TeYenWu/iWood/README.md

# iWood: Makeable Vibration Sensor for Interactive Plywood

## About
iWood is interactive plywood that can sense vibration based on triboelectric effect. As a material, iWood survives common woodworking operations, such as sawing, screwing, and nailing and can be used to create furniture and artifacts. Things created using iWood inherit its sensing capability and can detect a variety of user input and activities based on their unique vibration patterns. 

[[Project Video]](https://www.youtube.com/watch?v=MELff8HCPHg) [[PDF]](./assets/iWood.pdf) [[DOI]](/)

iWood

## Hardware
[Hadware page](./Hardware/README.md) descrbies how iWood can be fabricated and how smart things can be created using iWood.

## Firmware
No firmware now

## Software
[Software page](./Software/README.md) shows how to run iWood software programs, including the steps of data collection, training and demo.
