TeYenWu/iWood/Software/server/cm/confusion_matrix_cross-user.jpg

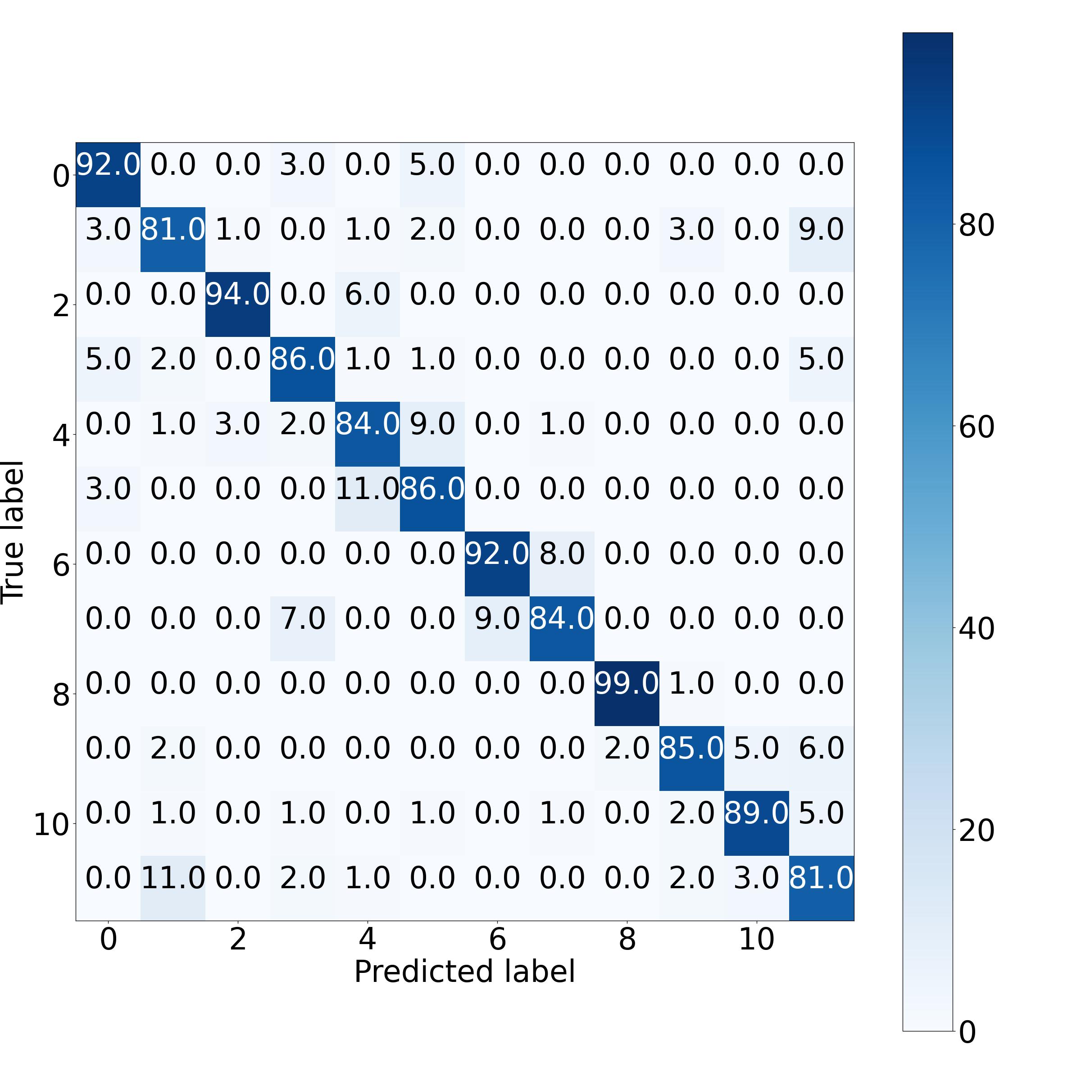
Software/server/cm/confusion_matrix_cross-user.jpg
