TeYenWu/iWood/Software/server/cm/confusion_matrix_cross_thing.jpg

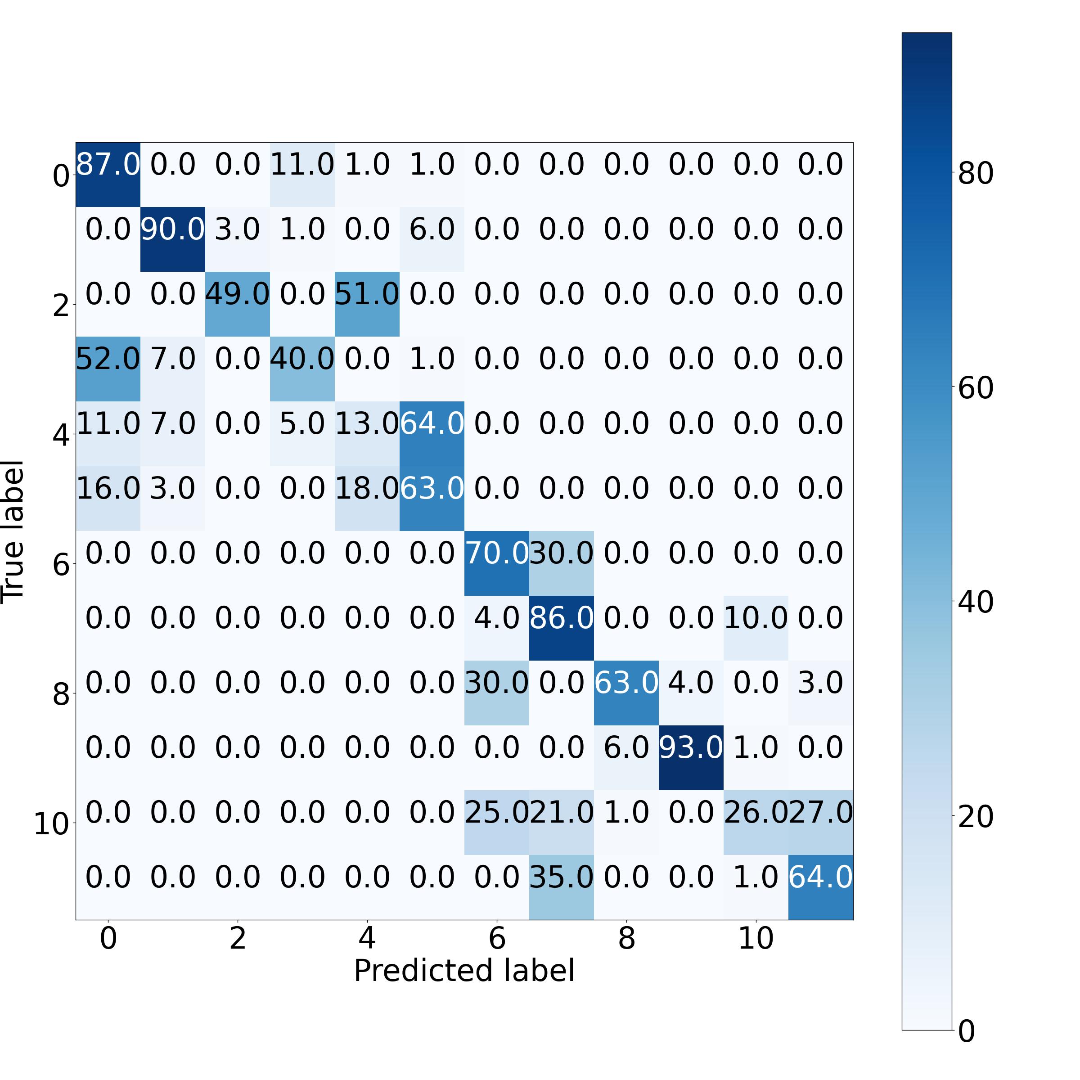
Software/server/cm/confusion_matrix_cross_thing.jpg
