TeYenWu/iWood/Software/server/cm/confusion_matrix_cuttingboard-cross-user.jpg

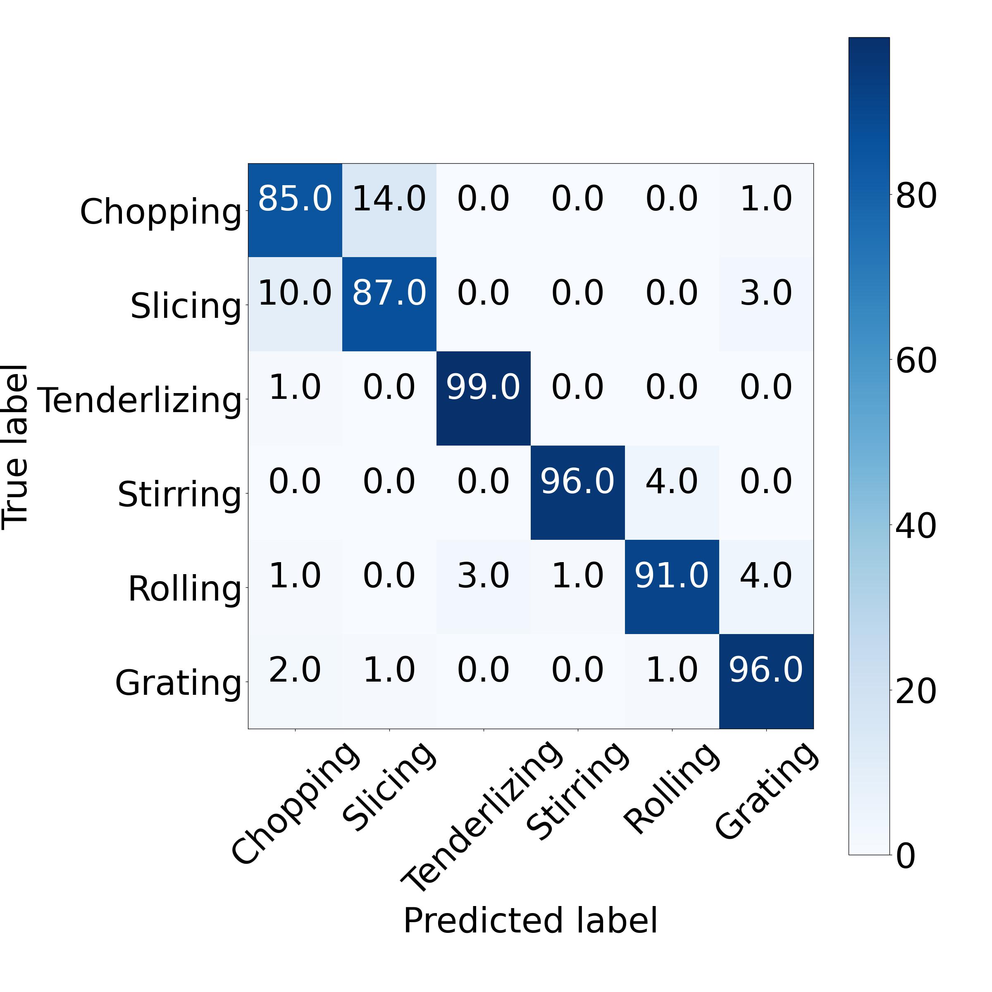
Software/server/cm/confusion_matrix_cuttingboard-cross-user.jpg
