TeYenWu/iWood/Software/server/cm/confusion_matrix_cuttingboard_crossuser.jpg

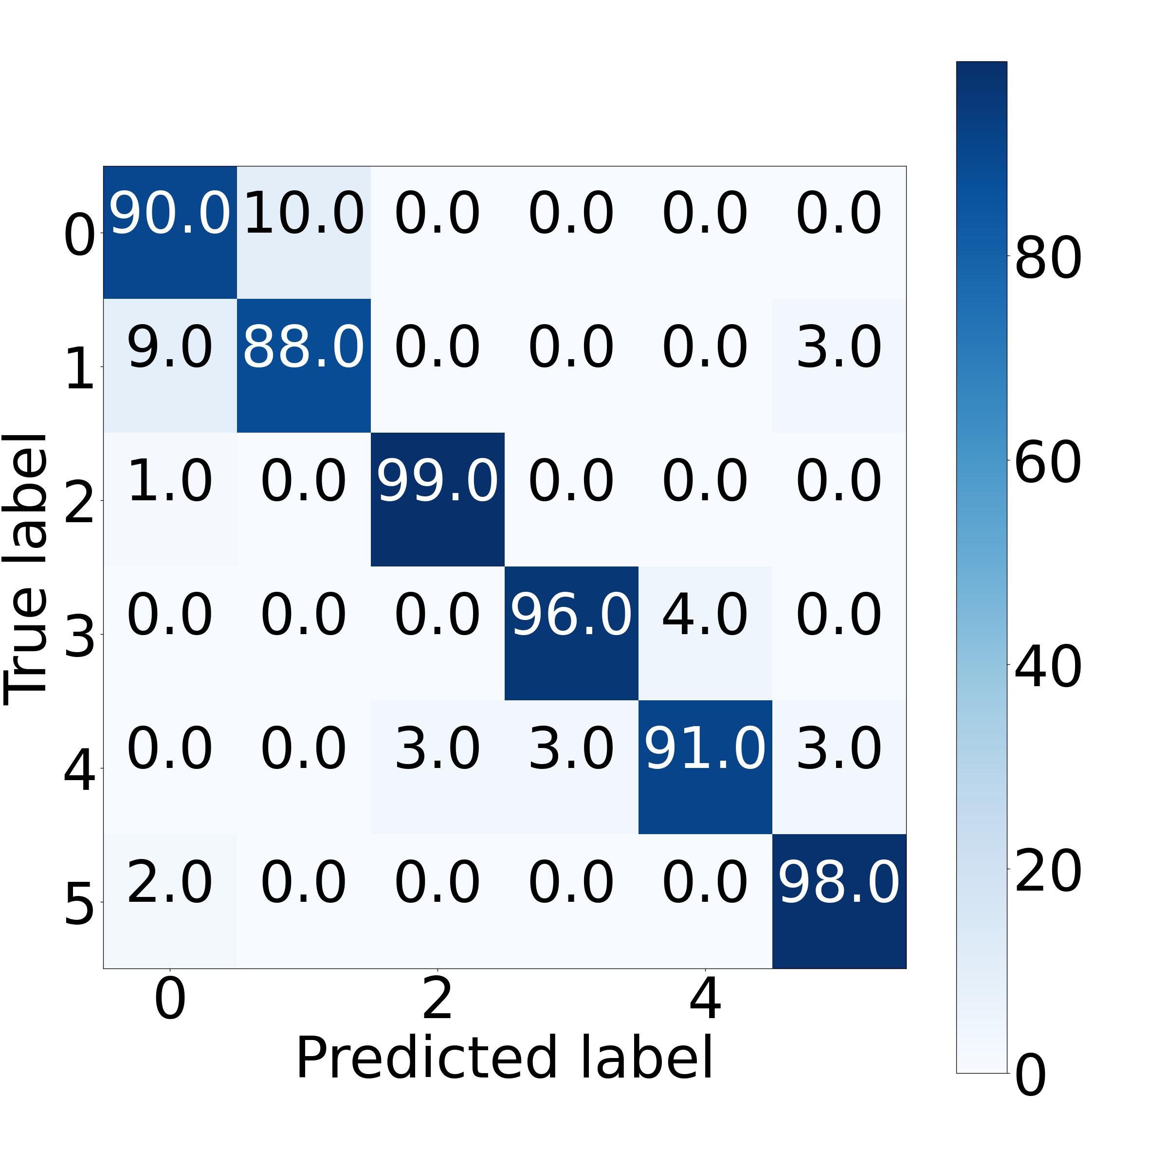
Software/server/cm/confusion_matrix_cuttingboard_crossuser.jpg
