TeYenWu/iWood/Software/server/cm/confusion_matrix_cuttingboard_withinuser.jpg

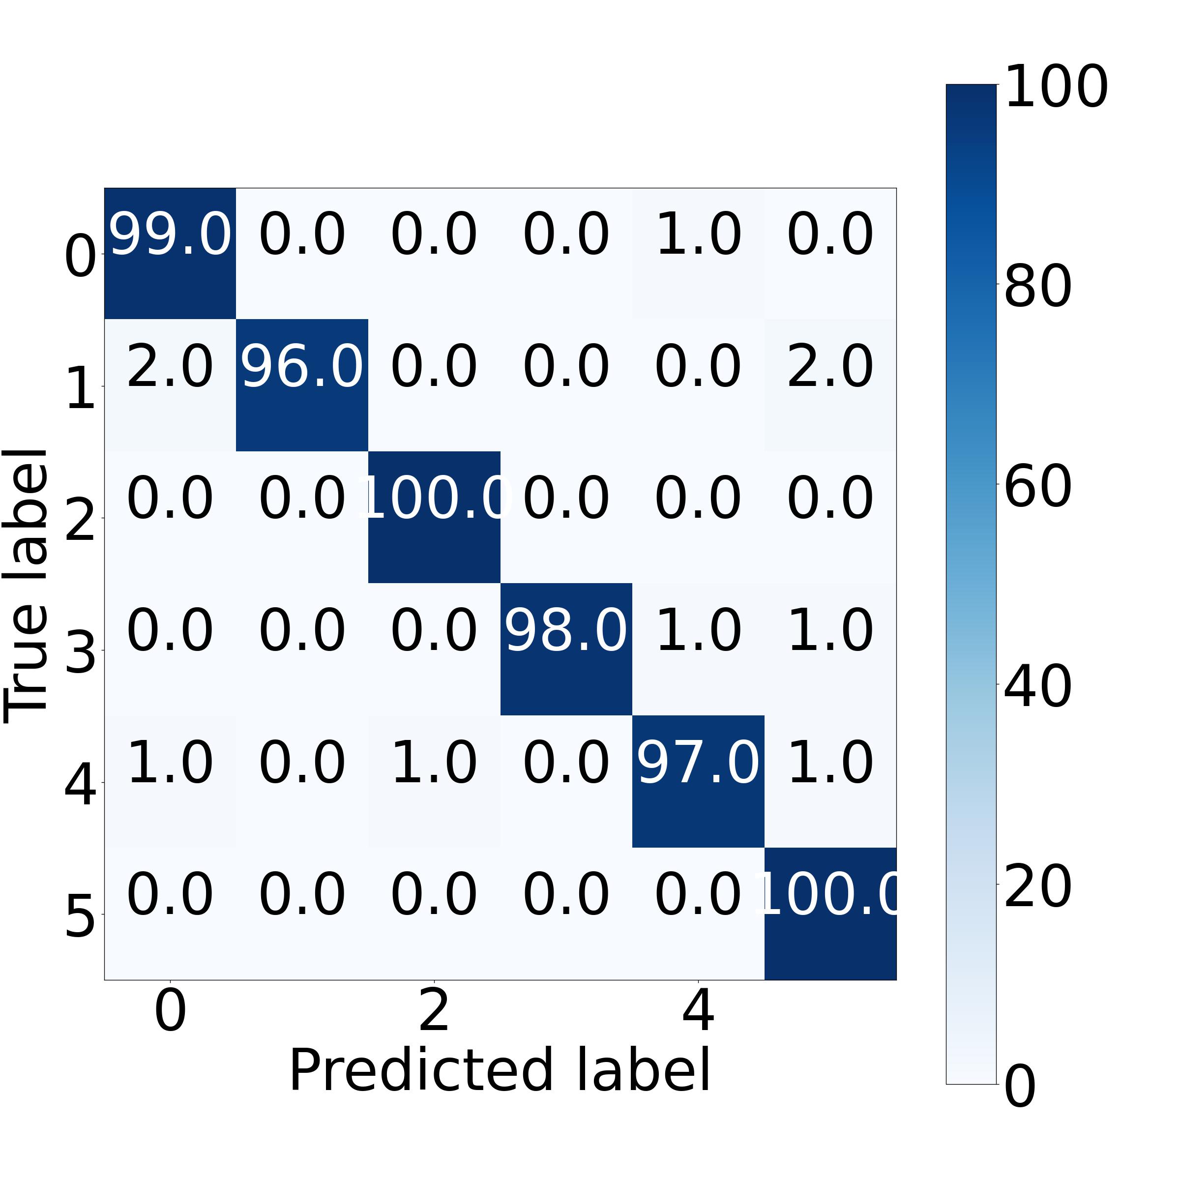
Software/server/cm/confusion_matrix_cuttingboard_withinuser.jpg
