TeYenWu/iWood/Software/server/cm/confusion_matrix_drawer-cross-user.jpg

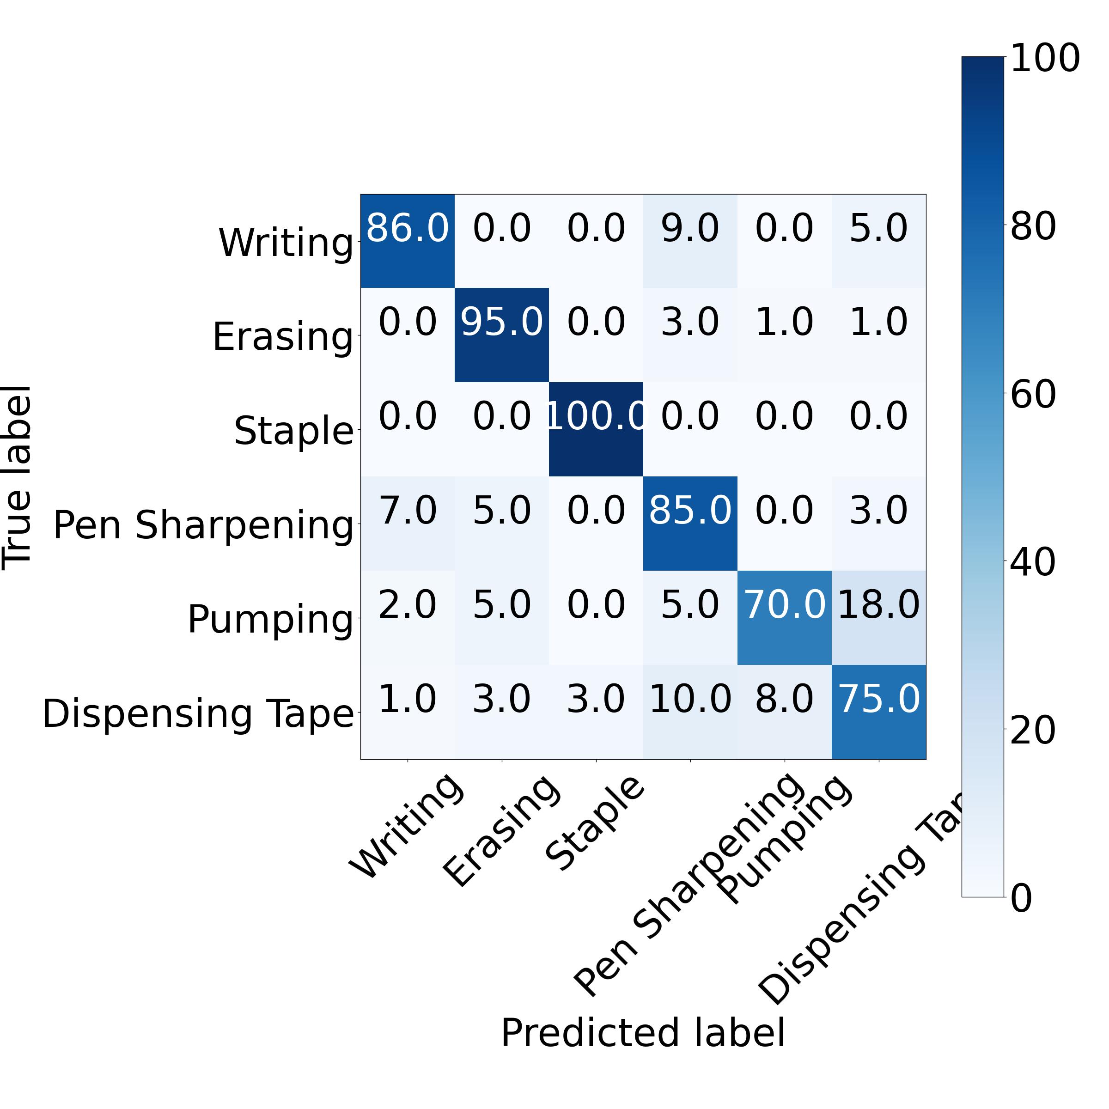
Software/server/cm/confusion_matrix_drawer-cross-user.jpg
