TeYenWu/iWood/Software/server/cm/confusion_matrix_table-cross-user.jpg

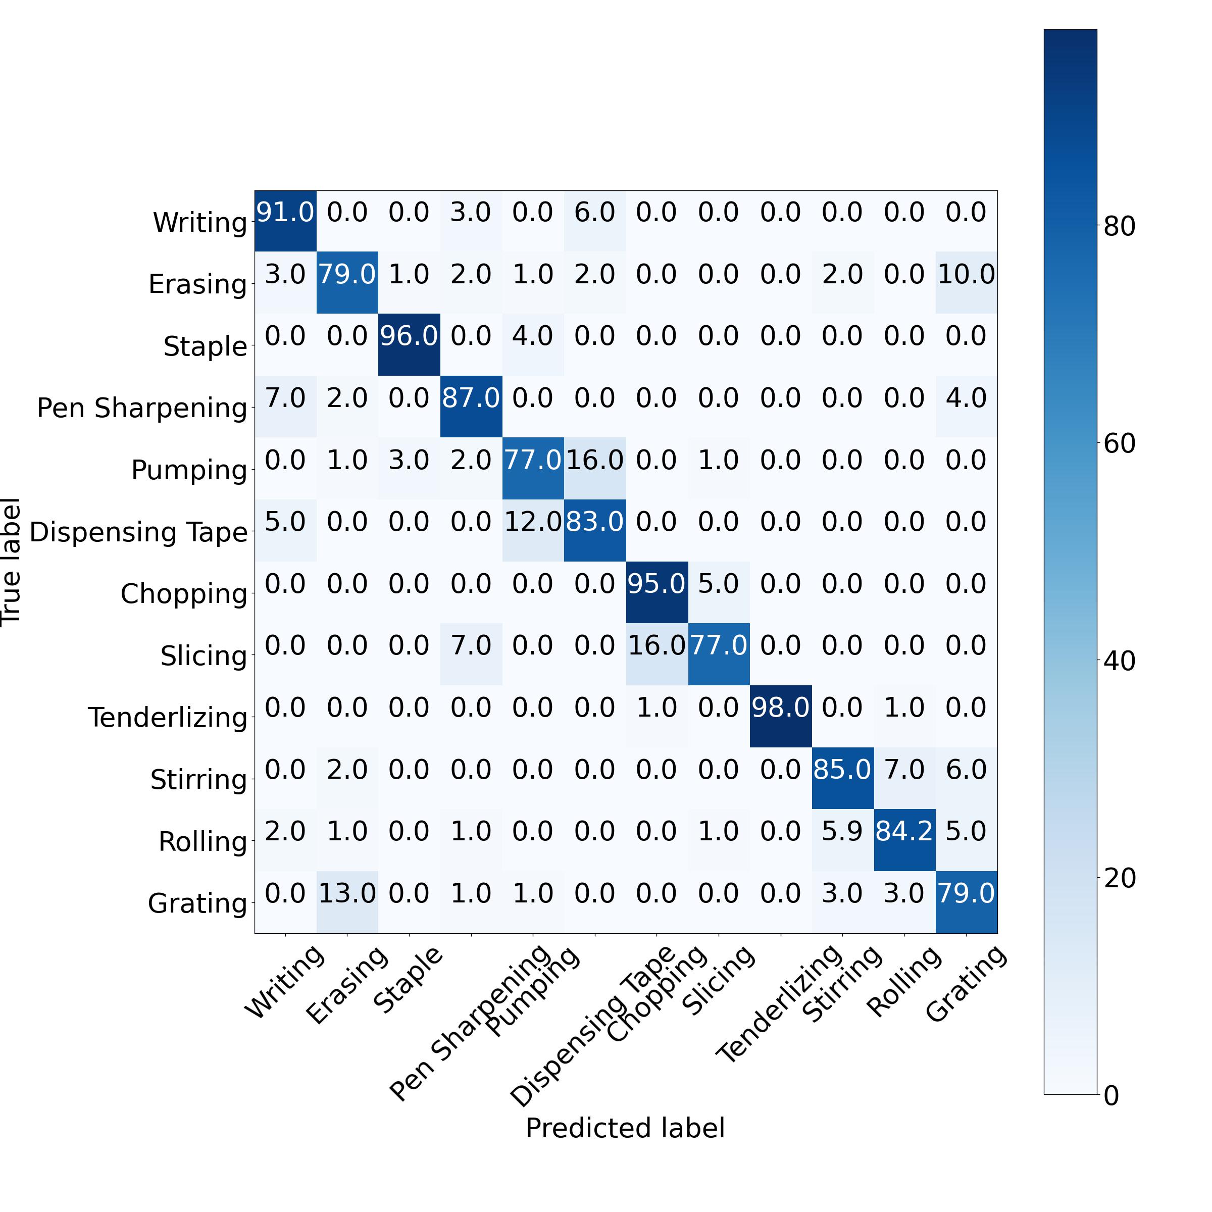
Software/server/cm/confusion_matrix_table-cross-user.jpg
