TeYenWu/iWood/Software/server/cm/confusion_matrix_within-user.jpg

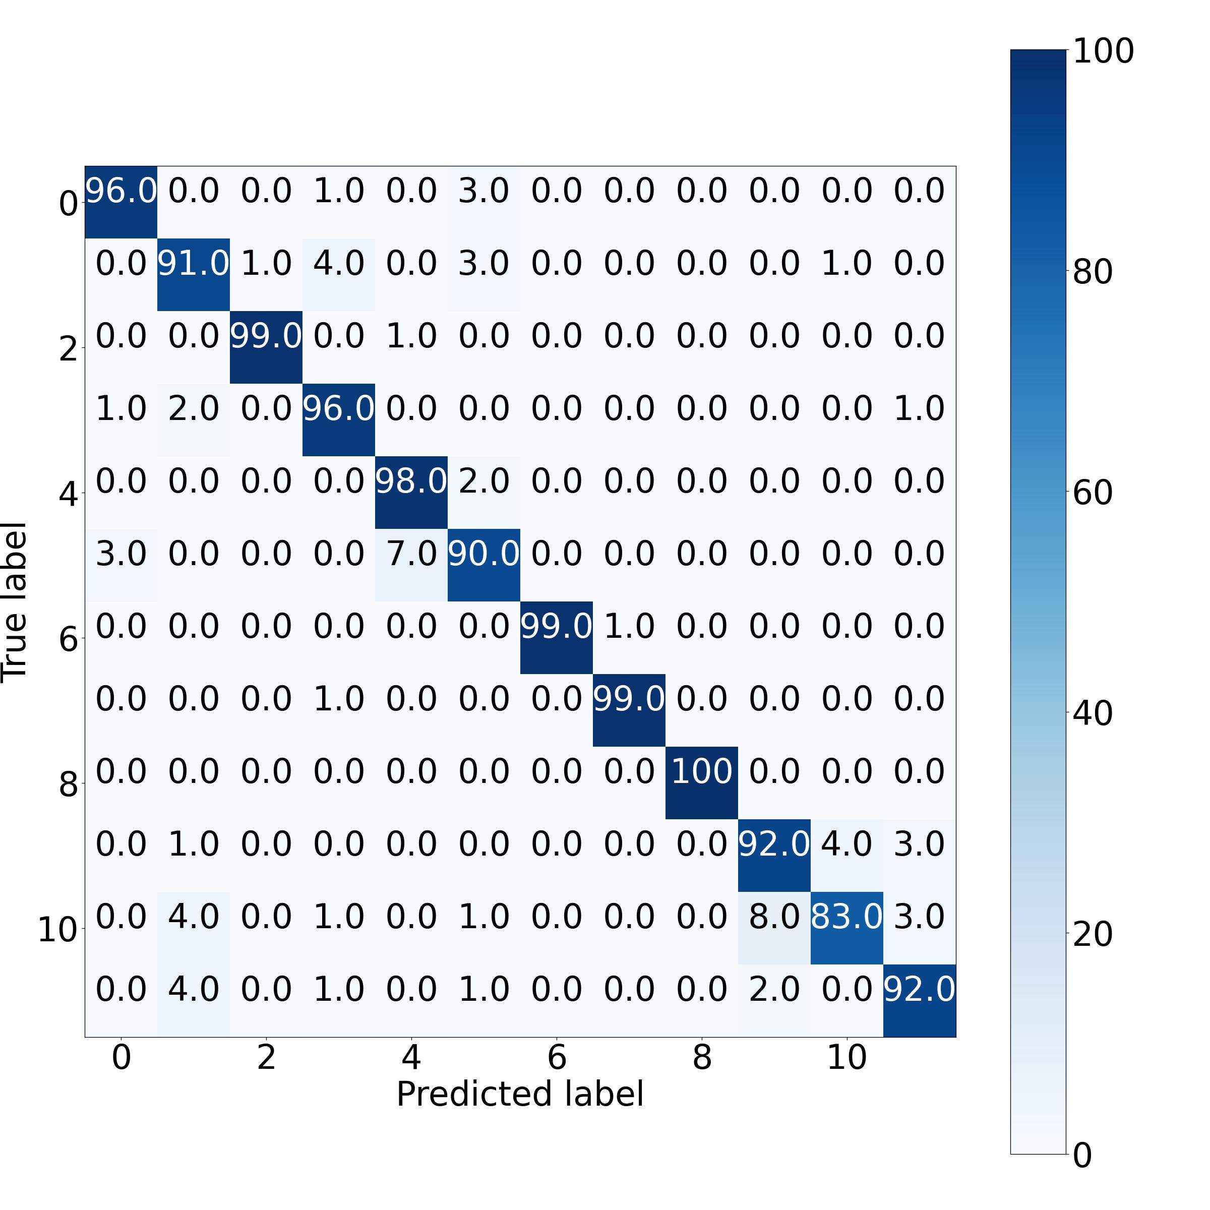
Software/server/cm/confusion_matrix_within-user.jpg
