TeYenWu/iWood/Software/server/cm/confusion_matrix_within_user_on_everything.jpg

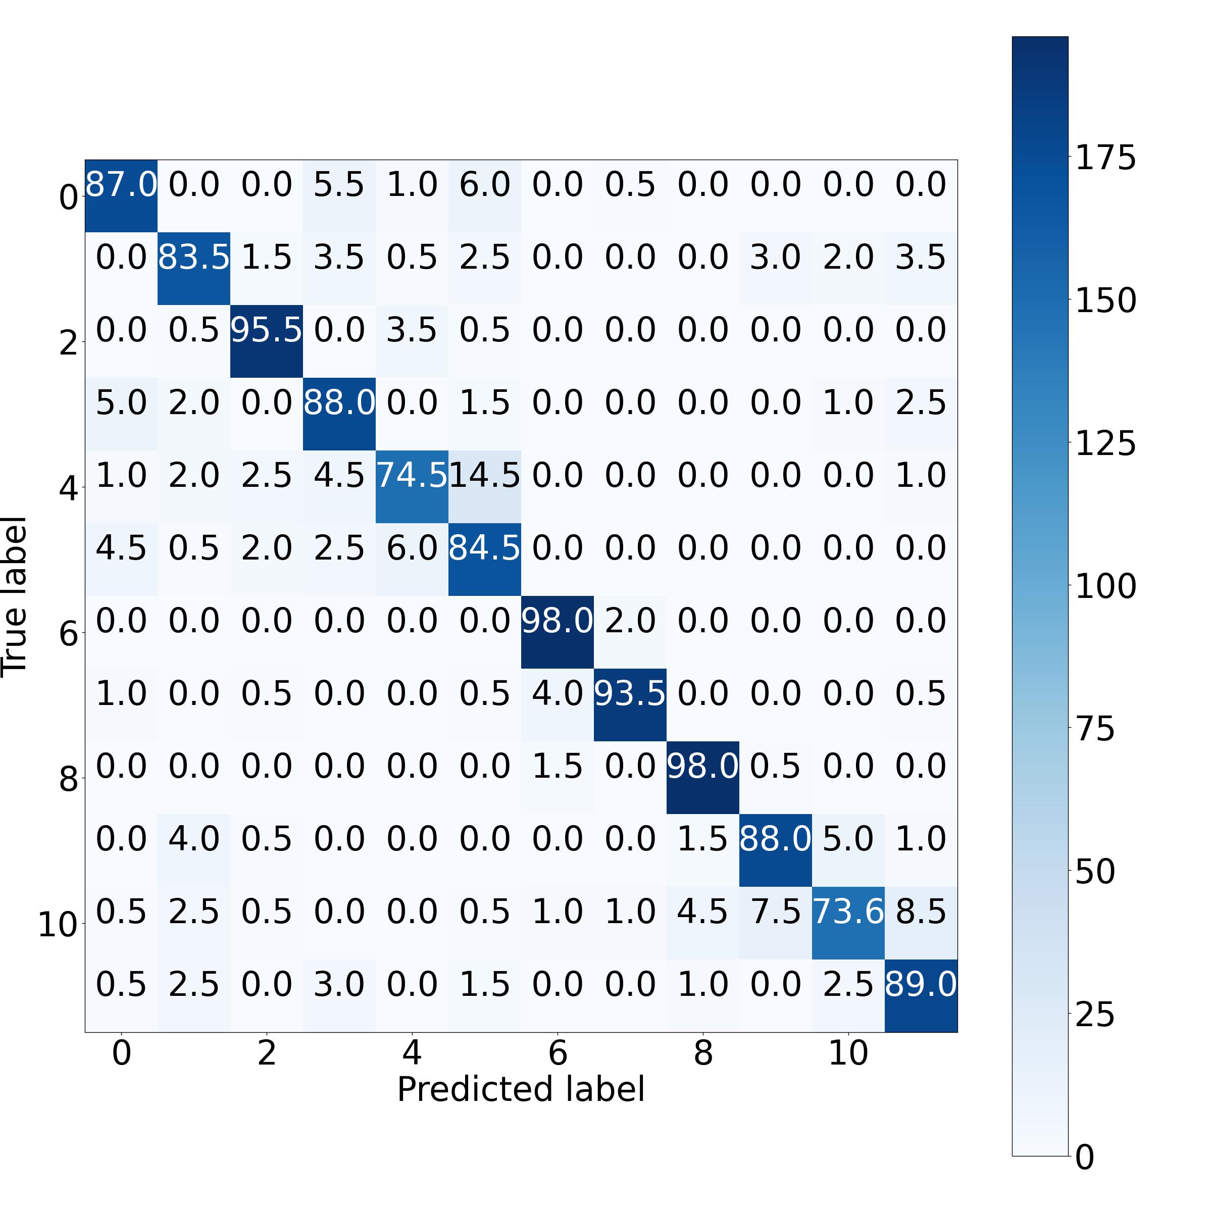
Software/server/cm/confusion_matrix_within_user_on_everything.jpg
