TeYenWu/iWood/Hardware/PatternGenerator/test_shape_images/star.png

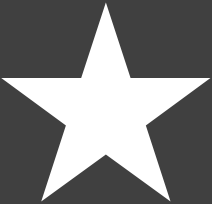
Hardware/PatternGenerator/test_shape_images/star.png
