TeYenWu/iWood/Hardware/PatternGenerator/test_shape_images/triangle.png

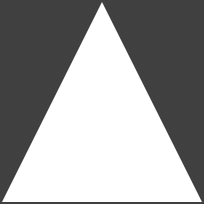
Hardware/PatternGenerator/test_shape_images/triangle.png
